costelpetrea/autonomous-line-follower-robot/photos/assembled2.jpeg

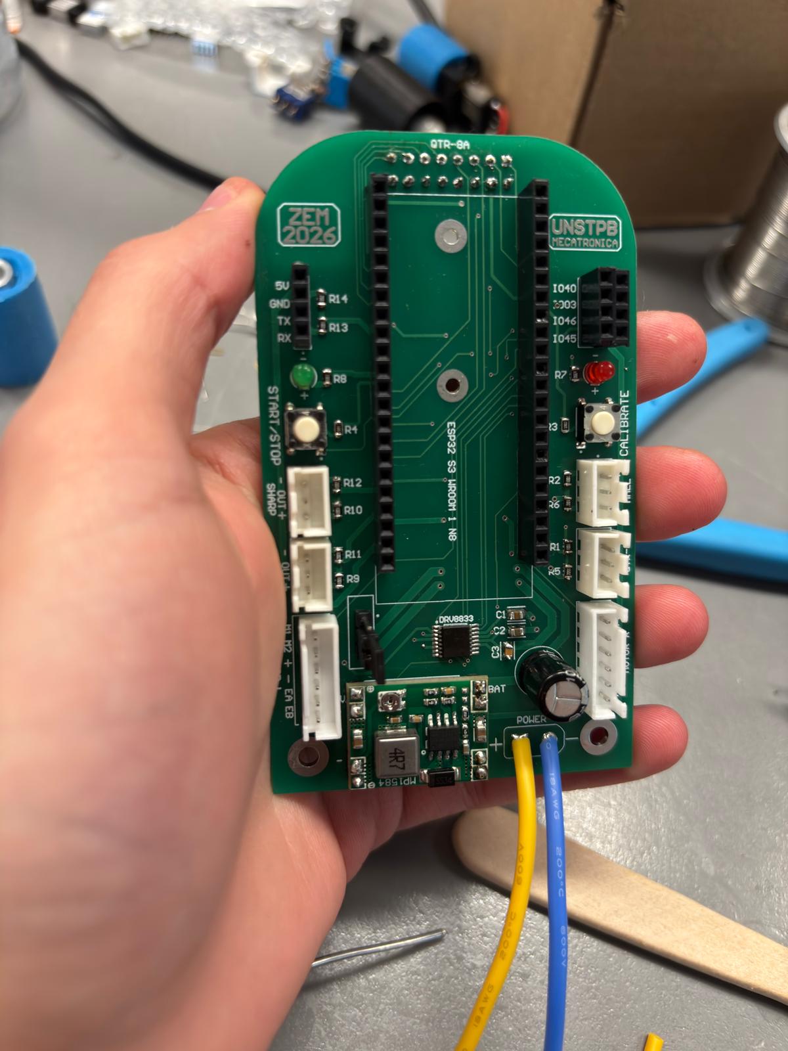
photos/assembled2.jpeg
