costelpetrea/autonomous-line-follower-robot/photos/assembled.jpeg

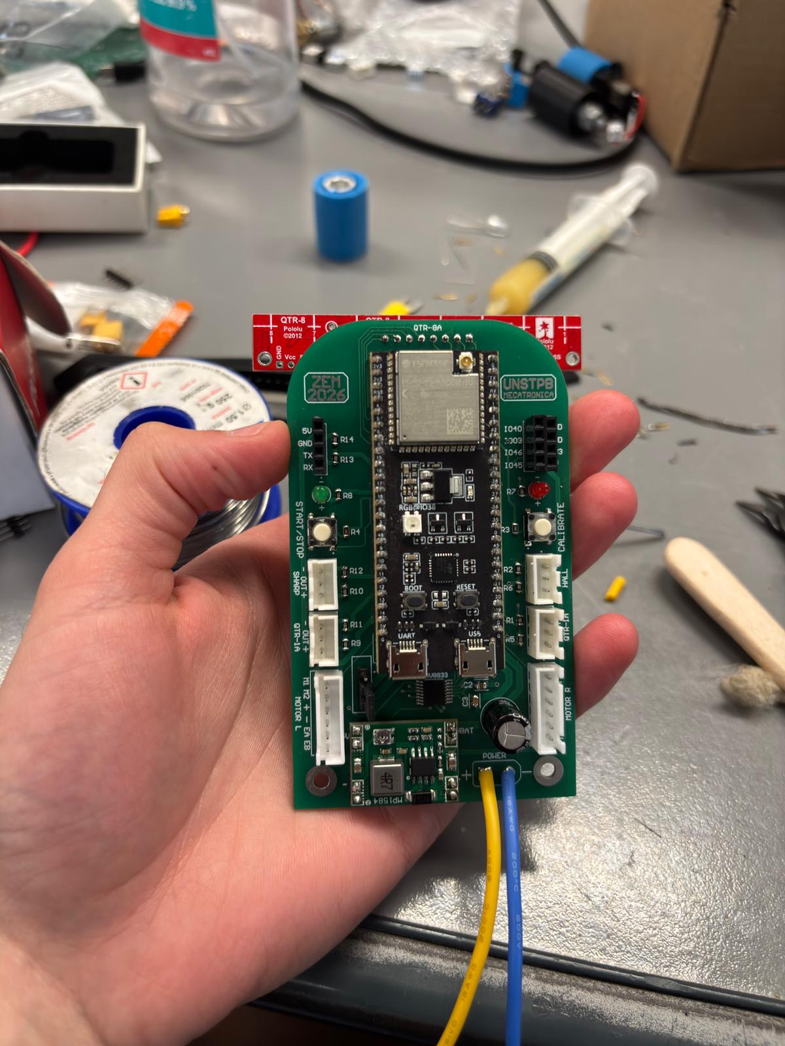
photos/assembled.jpeg
