costelpetrea/autonomous-line-follower-robot/README.md

# Autonomous Line Follower Robot - ZEM 2026









Fully autonomous line follower robot designed and built from scratch for **Zilele Educației Mecatronice (ZEM)** - a national mechatronics competition between Romanian engineering faculties. Everything is custom: PCB designed in Altium Designer, mechanical structure modeled in CAD, firmware written from scratch, and assembled and tuned by hand.

---

## 🏆 Competition

**Zilele Educației Mecatronice (ZEM)** is a national-level competition organized between Mechatronics faculties across Romania. Teams design and build autonomous robots from scratch, then compete live - requiring real-time hardware and software adjustments on the competition floor under pressure.

---

## ⚙️ Hardware Architecture

### 🧠 Microcontroller
- **ESP32-S3 WROOM-1U N8R8** - dual-core 240MHz, 8MB flash, 8MB PSRAM, tuning and telemetry

### 🔌 Motor Driver
- **DRV8833** - dual H-bridge motor driver integrated directly on the PCB, controlling two N20 motors

### 🚗 Motors
- **N20 micro gear motors with encoders** - closed-loop speed control via encoder feedback for precise differential drive

### 📡 Sensor Array
- **QTR-8A** - 8-channel reflectance sensor bar for line detection and position calculation
- **QTR-1A** - individual sensors for specific detection zones

### 🔍 Additional Sensors
- **Hall effect sensor** - magnetic field detection
- **Distance sensor** - obstacle detection and course adaptation

### 🖨️ PCB
- Fully custom PCB designed in **Altium Designer**
- All drivers, power regulation, sensor connectors, and MCU integrated on a single board
- Designed for minimal footprint and optimal weight distribution on the chassis

---

## 💻 Firmware

- Written from scratch for ESP32-S3
- **PID control loop** for line following using QTR-8A weighted centroid position
- **Encoder feedback** for closed-loop motor speed control
- Real-time sensor calibration routines

---

## 🔩 Mechanical Design

- Full robot chassis modeled in Fusion360
- Designed for low center of gravity and sensor bar alignment
- Custom mounts for PCB, motors, and sensor array
- Parts manufactured via 3D printing
  
---

## 🛠️ Tech Stack

| Category | Details |
|---|---|
| PCB Design | Altium Designer |
| MCU | ESP32-S3 WROOM-1U N8R8 |
| Motor driver | DRV8833 (on-board) |
| Motors | N20 with encoders |
| Line sensor | QTR-8A (array) |
| Extra sensors | Hall effect, distance, QTR-1A |
| CAD | Fusion 360 |
| Manufacturing | Custom PCB + 3D printed chassis |
| Firmware | C++ |

---

## 📁 What's in This Repo

-  `cad/` — FUSION 360 chassis files
- `firmware/` — ESP32-S3 source code (PID, encoder, sensor routines)
- `pcb/` — Altium Designer project files (schematic + layout)
- `photos/` — PCB, assembled robot, competition photos
- `videos/` — Assembled working robot, competition videos

---

## 🧠 What I Learned

- Full PCB design cycle: schematic → layout → fabrication → assembly → test
- SMD soldering and board bring-up from scratch
- PID tuning on a physical system under real competition conditions
- Integrating multiple sensor types into a single control loop
- Making fast hardware and software decisions under competition time pressure
- Designing for manufacturability and repairability in a competition context

---

## 📅 Ongoing

**2026** | National competition — Zilele Educației Mecatronice
