costelpetrea/autonomous-line-follower-robot/photos/car2.jpeg

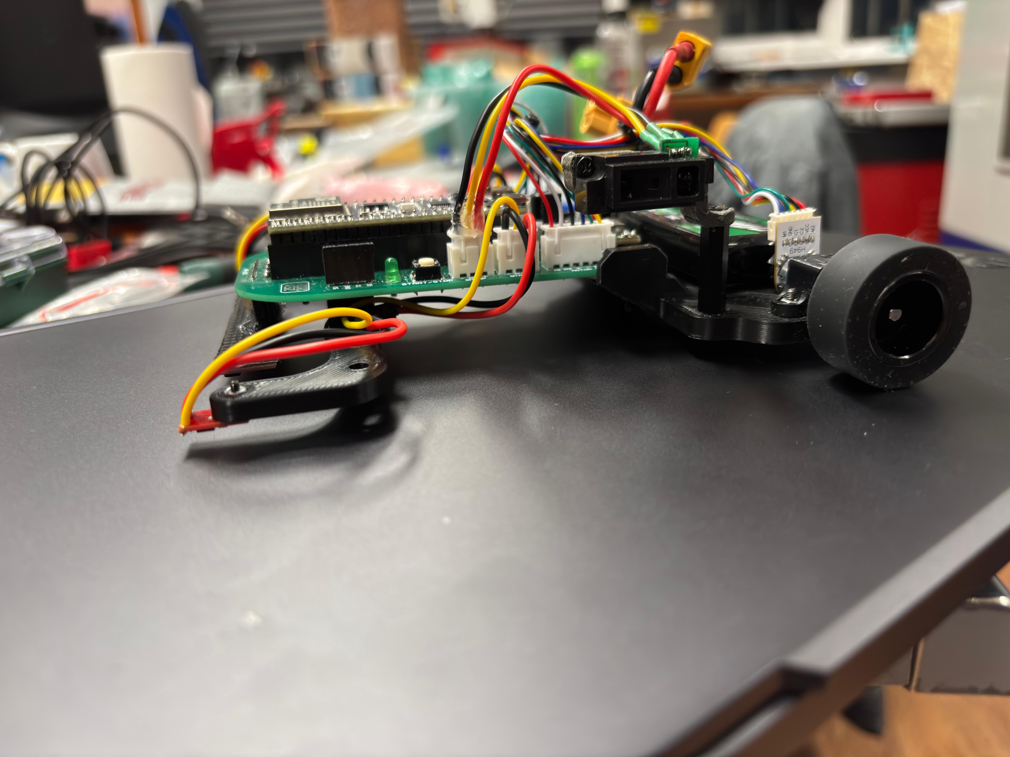
photos/car2.jpeg
