costelpetrea/autonomous-line-follower-robot/photos/car-pose.jpeg

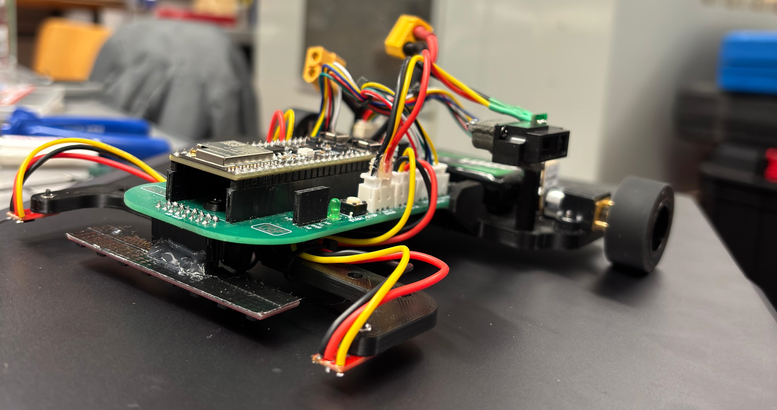
photos/car-pose.jpeg
