costelpetrea/autonomous-line-follower-robot/photos/car.jpeg

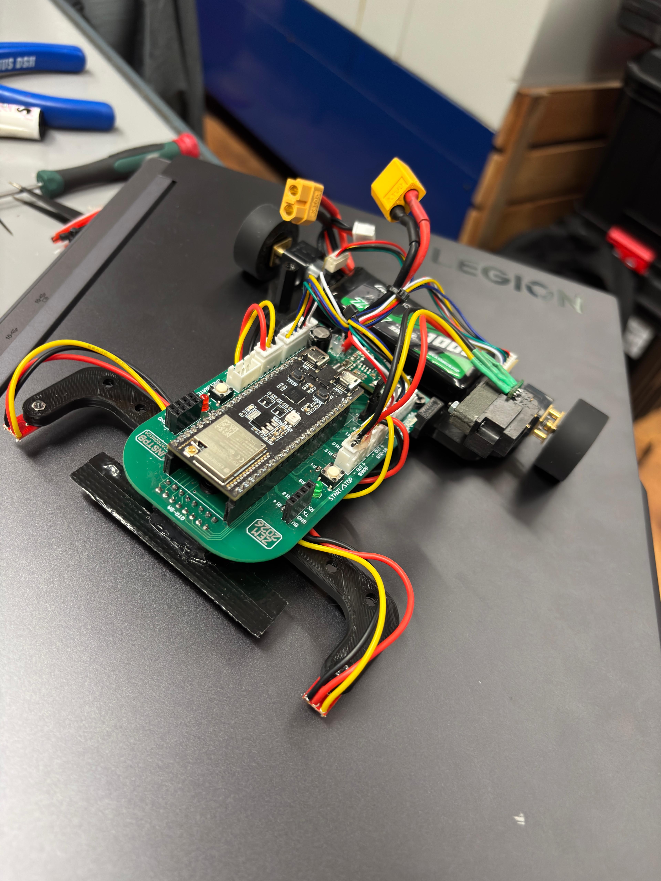
photos/car.jpeg
