costelpetrea/autonomous-line-follower-robot/photos/care-side.jpeg

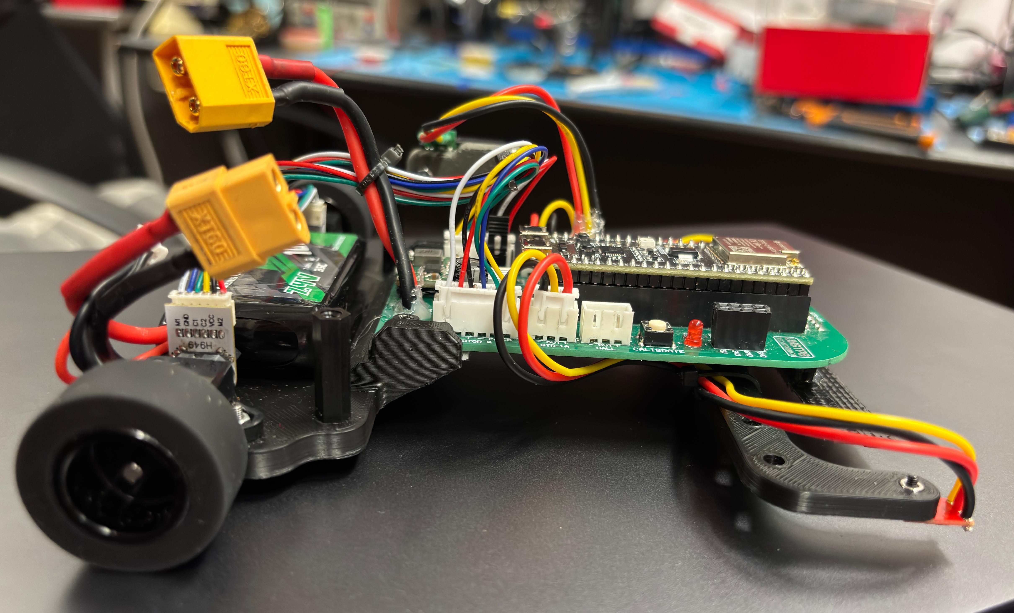
photos/care-side.jpeg
