costelpetrea/autonomous-line-follower-robot/photos/pcb1.jpeg

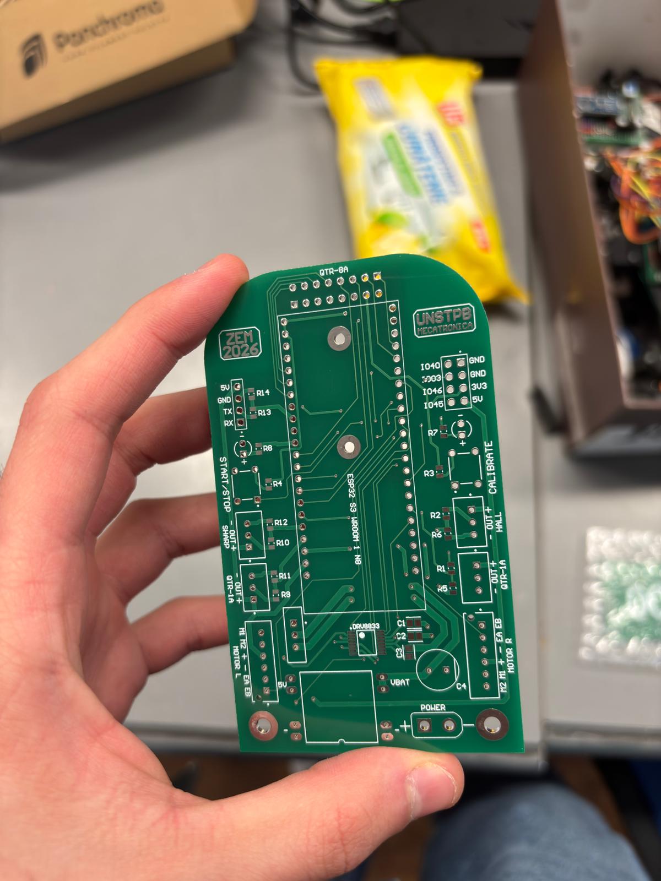
photos/pcb1.jpeg
