costelpetrea/autonomous-line-follower-robot/photos/pcb2.jpeg

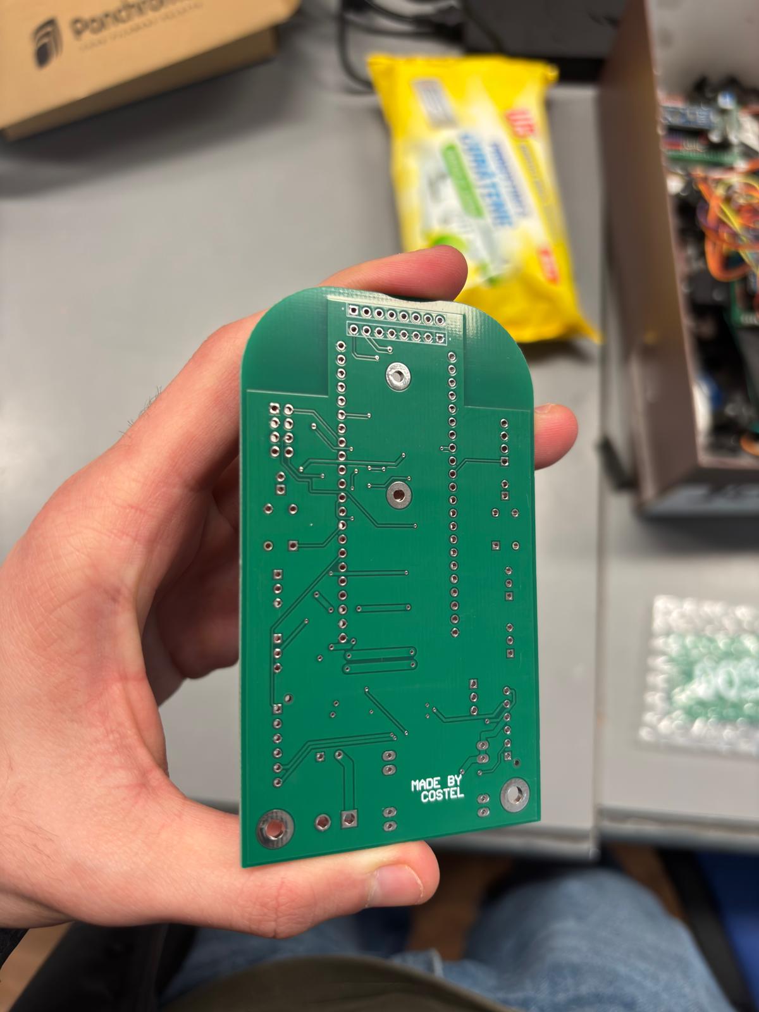
photos/pcb2.jpeg
