costelpetrea/autonomous-line-follower-robot/(list of files, cad)

Other CAD files:
cad/line-follower.f3z
