costelpetrea/autonomous-line-follower-robot/pcb/LineFollower.pdf

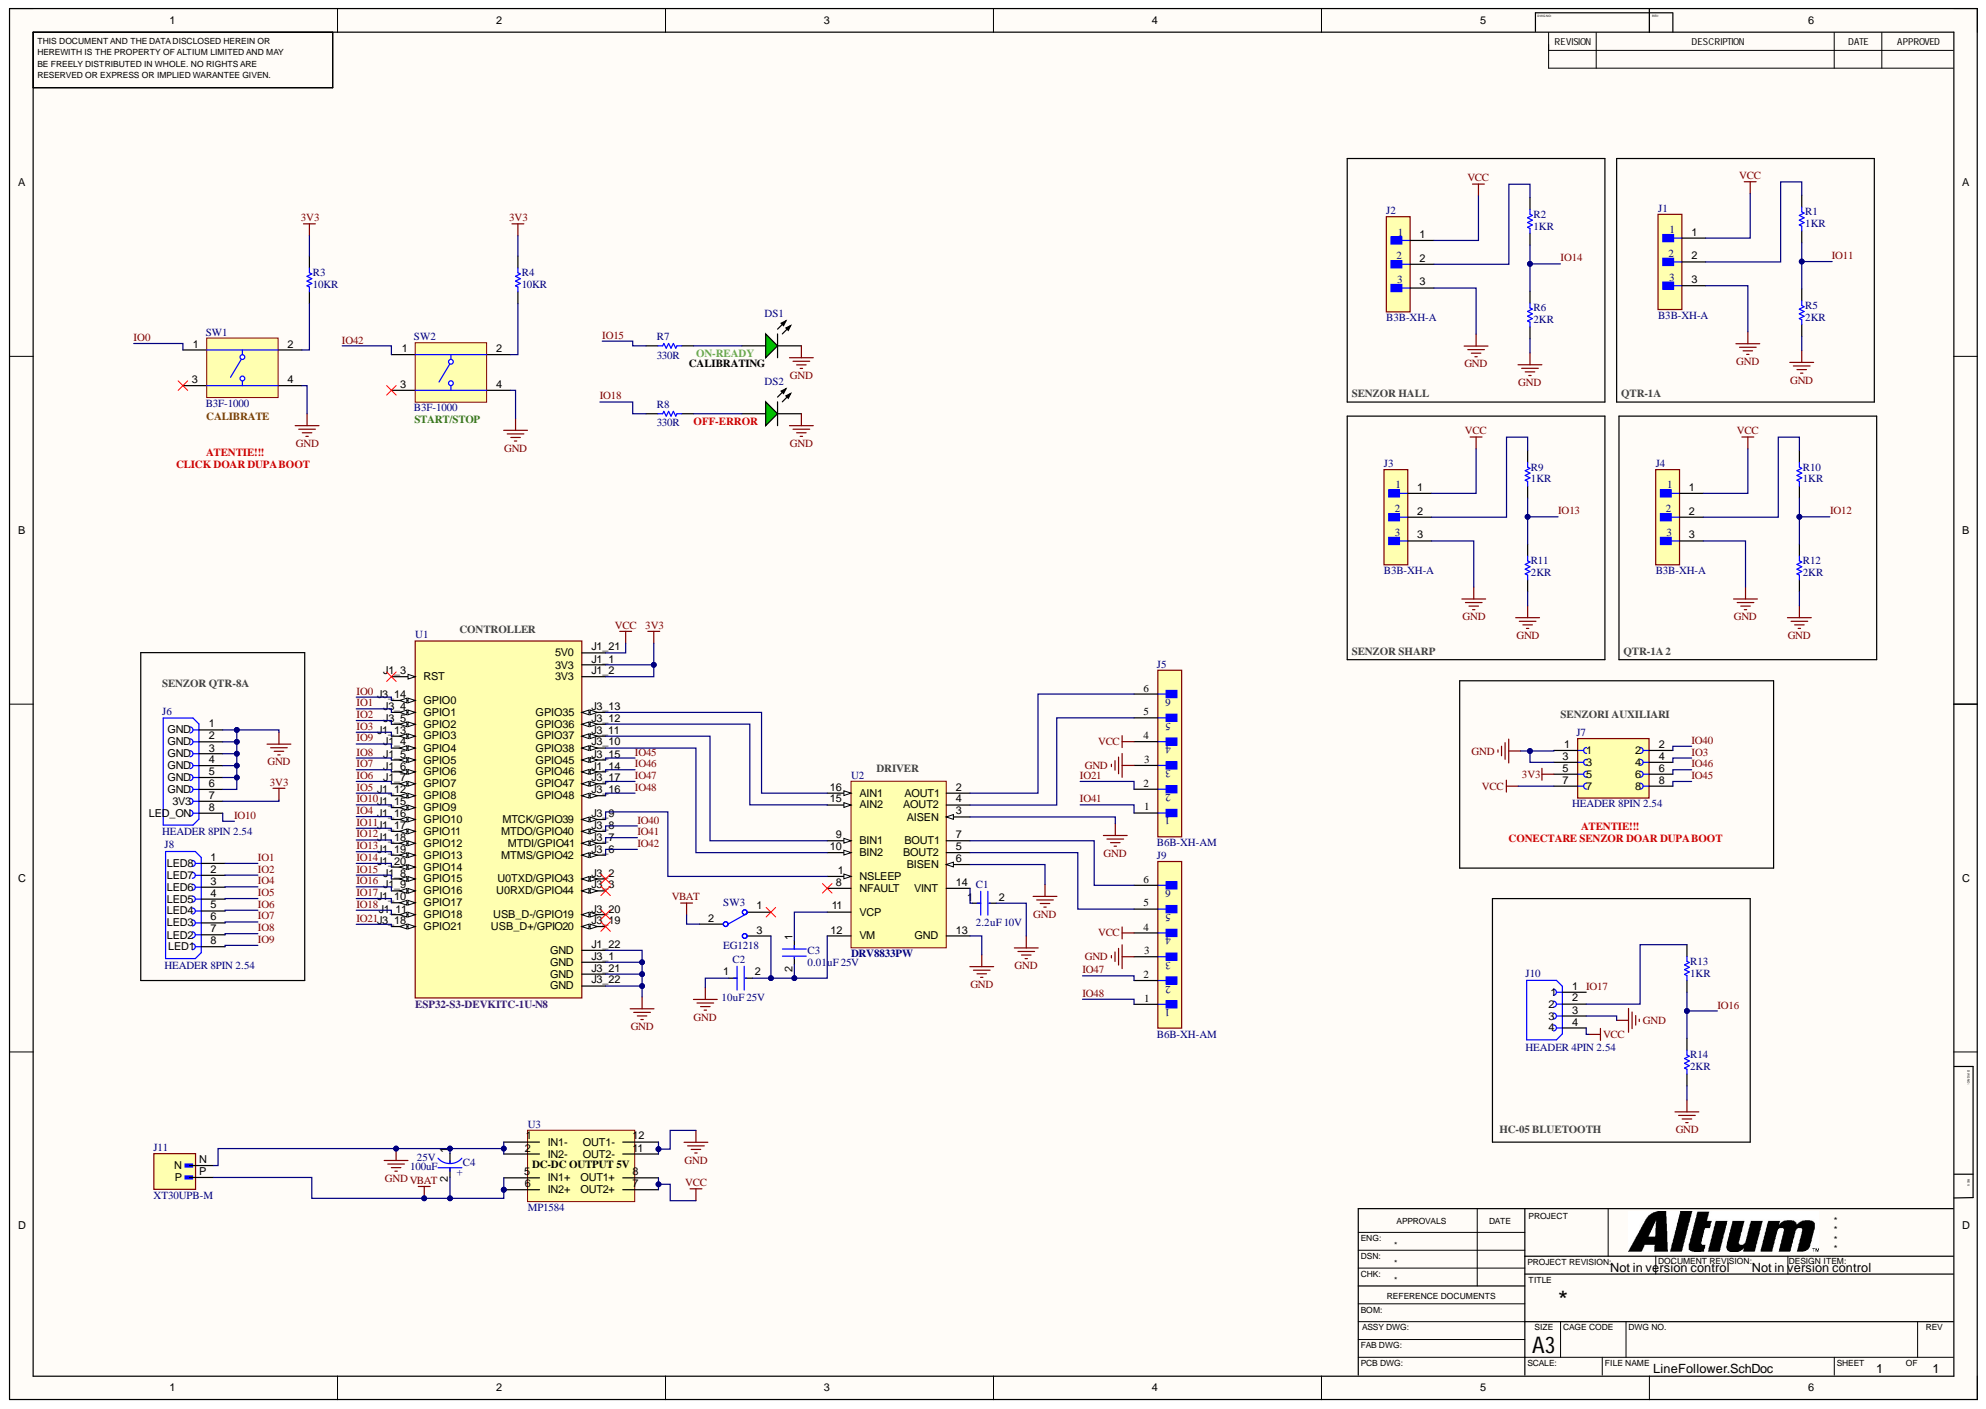
[picture p9: page 1]

THIS DOCUM ENT AND THE DATA DISCLOS ED HEREIN OR HERE WITH IS THE PROP ERT Y OF A LTIUM LIMIT ED AND M AY B E FRE E LY DIS TRIBUT ED IN WHOL E. NO RIGHT S ARE RE S ERV ED OR E X PRE S S OR IM P LIED W ARANT E E GIV EN. | | R E V I S I ON | D E S C R I PT I ON | D AT E | A P P R OVE D

CONECTARE SENZOR DOAR DUP

ENG:
** DSN: | PROJECT RE VISION: Not i n v | DOCUM ENT RE VISION: ers i o n c o ntro l Not i n | DE SIGN IT E M : v ers i o n c o ntro l
CHK : | TIT L E *
