costelpetrea/autonomous-line-follower-robot/(list of files, drawings)

Other design files:
pcb/Copy of LineFollower.PcbDoc
pcb/LineFollower.PcbDoc
pcb/LineFollower.PrjPcb
pcb/LineFollower.SchDoc
