costelpetrea/autonomous-line-follower-robot/photos/assembled qtr-8a.jpeg

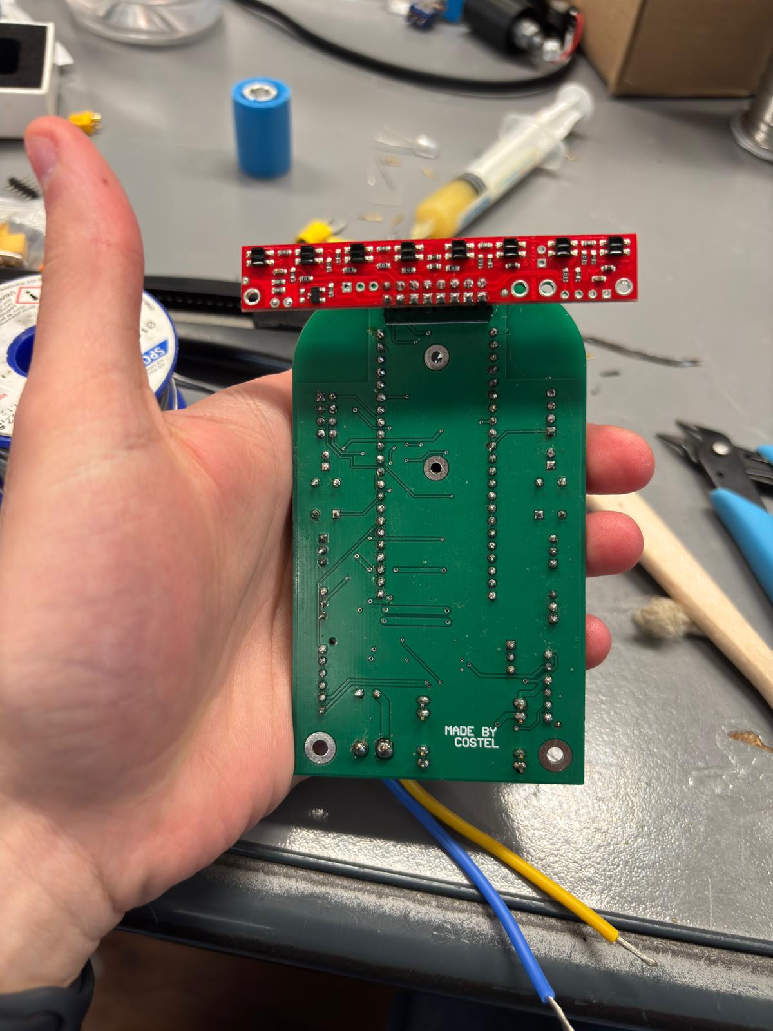
photos/assembled qtr-8a.jpeg
