costelpetrea/autonomous-line-follower-robot/photos/testing qtr-8a.jpeg

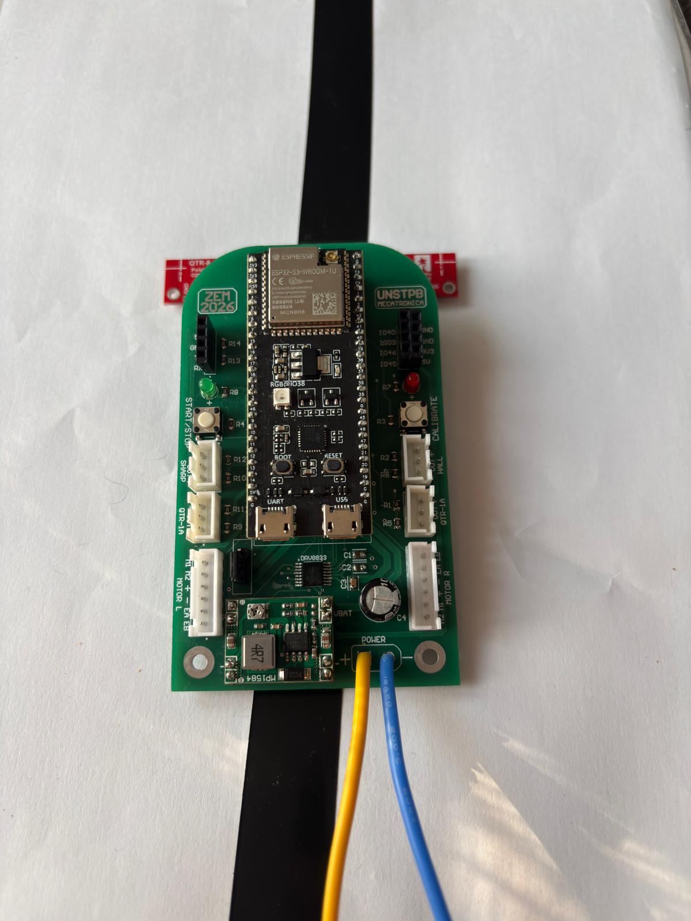
photos/testing qtr-8a.jpeg
